yingzhexu/esp32-codex-quota-gauge/hardware/images/V5_servo_posts.png

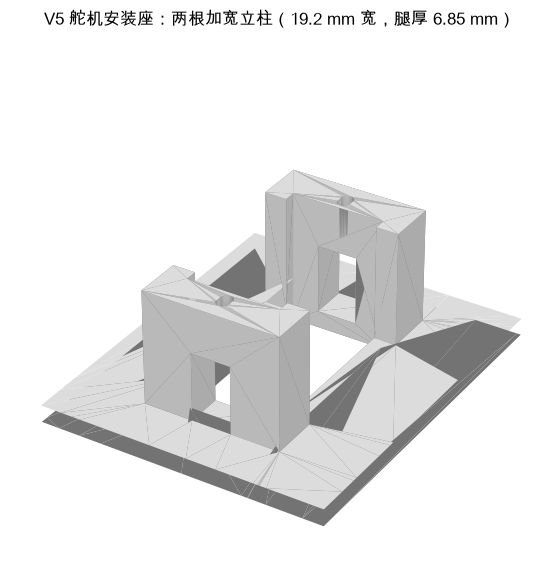
hardware/images/V5_servo_posts.png
