yingzhexu/esp32-codex-quota-gauge/hardware/CAD/V5_full_assembly.step

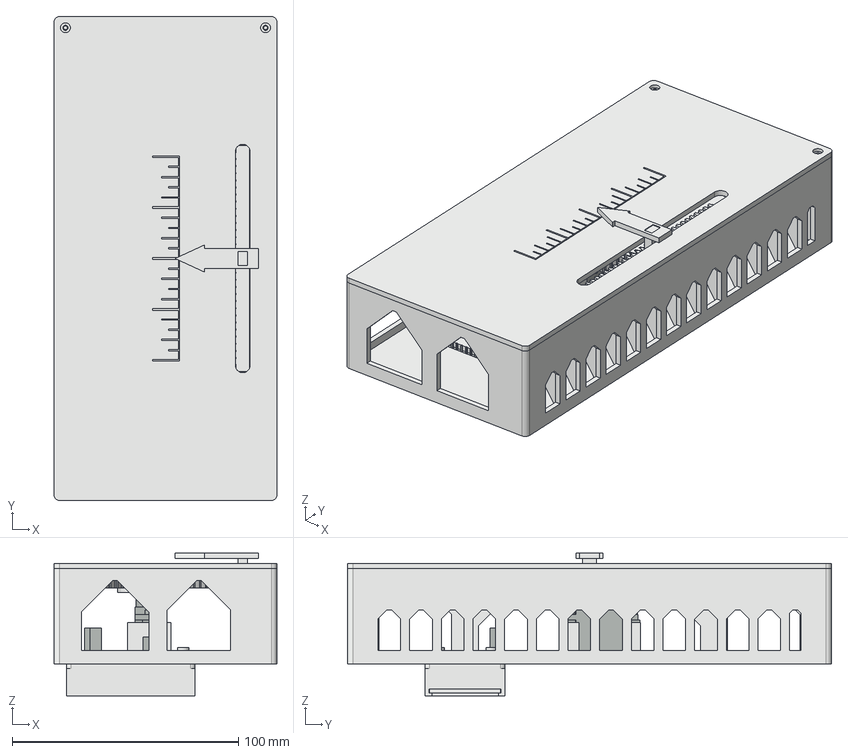
[picture p3: CAD file, 2026-10-23]
hardware/CAD/V5_full_assembly.step
98.5 x 214.0 x 63.2 mm
01_plaque_back
02_front
03_pinion_74T
04_horn_keeper
05_rack_slider
06_arrow
07_pod_base
08_pod_lid
REF_SG90
REF_EAR_SHIMS
REF_HORN
REF_HORN_SCREW
REF_PCB
REF_COMPONENTS
REF_USB
REF_HEADERS
REF_DUPONT_ENVELOPE
