yingzhexu/esp32-codex-quota-gauge/hardware/CAD/T5_horn_fit.step

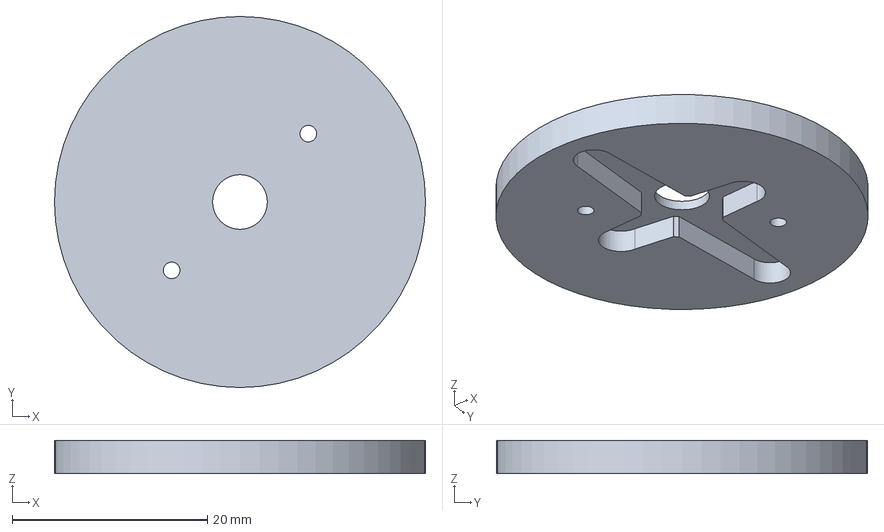
[picture p4: CAD file, 2026-10-23]
hardware/CAD/T5_horn_fit.step
38.0 x 38.0 x 3.40 mm
