yingzhexu/esp32-codex-quota-gauge/hardware/STL/S_servo_ear_shim_1.0mm_print2.stl

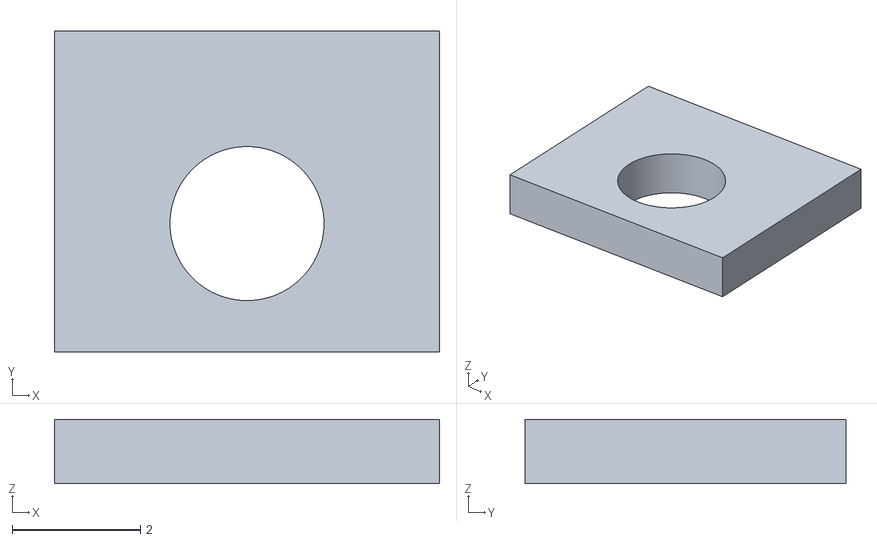
[picture p5: CAD file, 2026-10-23]
hardware/STL/S_servo_ear_shim_1.0mm_print2.stl
6.00 x 5.00 x 1.00
