yingzhexu/esp32-codex-quota-gauge/hardware/CAD/T3_pilot_and_journal.step

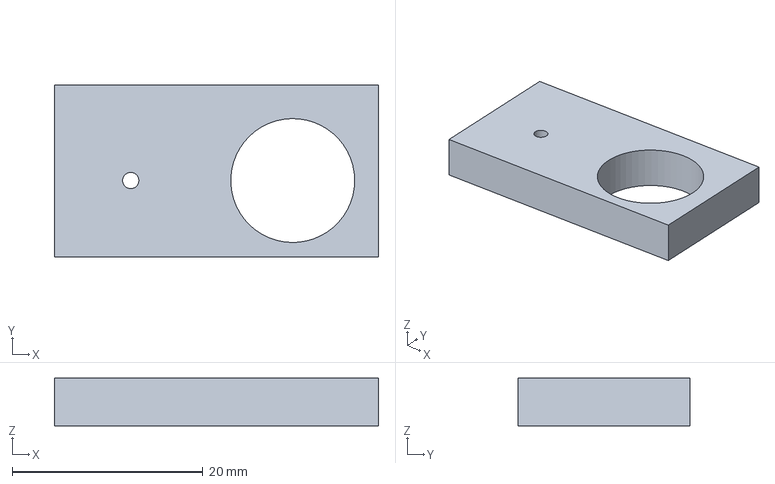
[picture p6: CAD file, 2026-10-23]
hardware/CAD/T3_pilot_and_journal.step
34.0 x 18.0 x 5.00 mm
