yingzhexu/esp32-codex-quota-gauge/hardware/CAD/T2_slider_sample.step

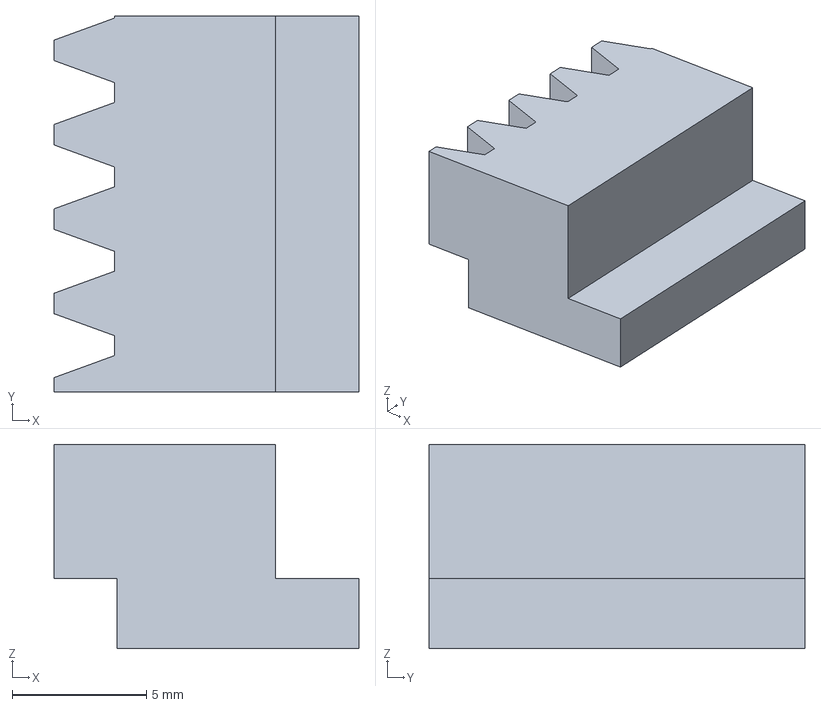
[picture p8: CAD file, 2026-10-23]
hardware/CAD/T2_slider_sample.step
11.3 x 14.0 x 7.60 mm
