yingzhexu/esp32-codex-quota-gauge/hardware/CAD/02_front.step

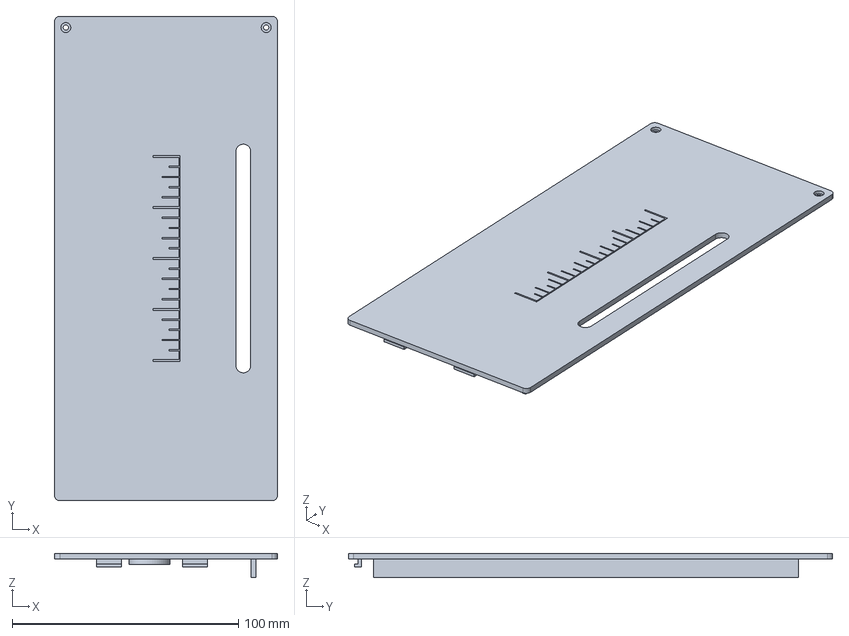
[picture p10: CAD file, 2026-10-23]
hardware/CAD/02_front.step
98.5 x 214.0 x 10.7 mm
