yingzhexu/esp32-codex-quota-gauge/hardware/STL/S_servo_ear_shim_0.5mm_print2.stl

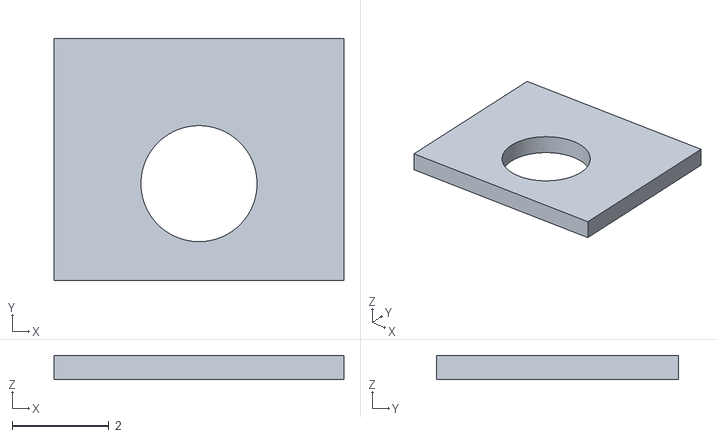
[picture p11: CAD file, 2026-10-23]
hardware/STL/S_servo_ear_shim_0.5mm_print2.stl
6.00 x 5.00 x 0.5
