yingzhexu/esp32-codex-quota-gauge/hardware/CAD/07_pod_base.step

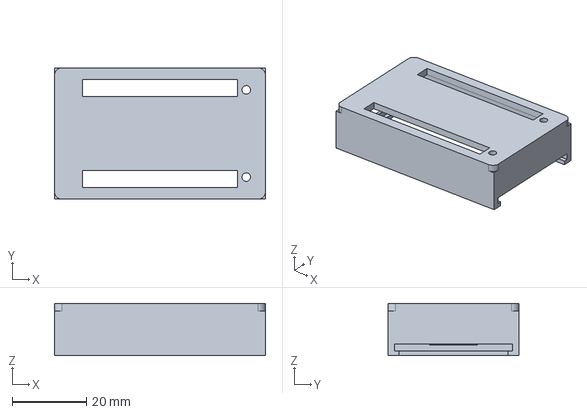
[picture p12: CAD file, 2026-10-23]
hardware/CAD/07_pod_base.step
56.9 x 35.3 x 14.1 mm
