yingzhexu/esp32-codex-quota-gauge/hardware/STL/optional_horn_spacer_0.8mm.stl

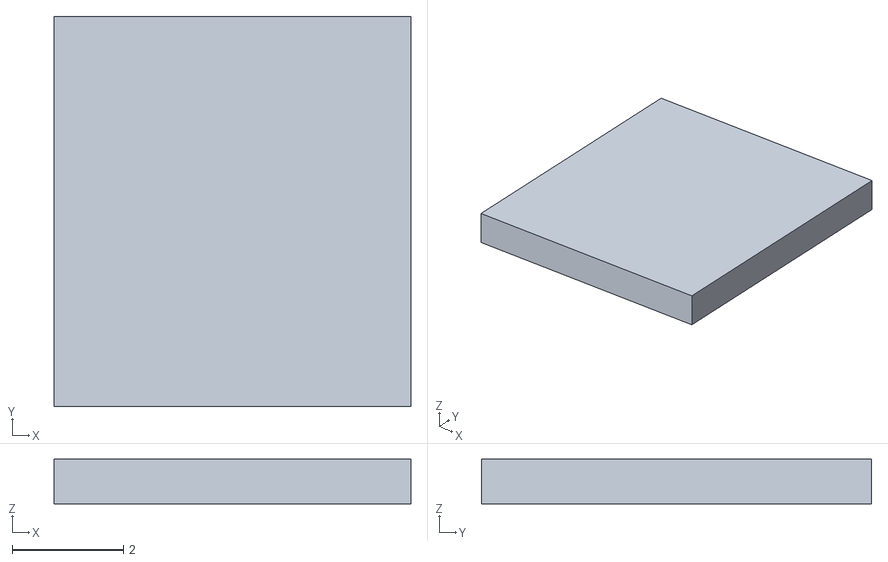
[picture p13: CAD file, 2026-10-23]
hardware/STL/optional_horn_spacer_0.8mm.stl
6.40 x 7.00 x 0.8
