yingzhexu/esp32-codex-quota-gauge/hardware/CAD/T4_front_lip_sample.step

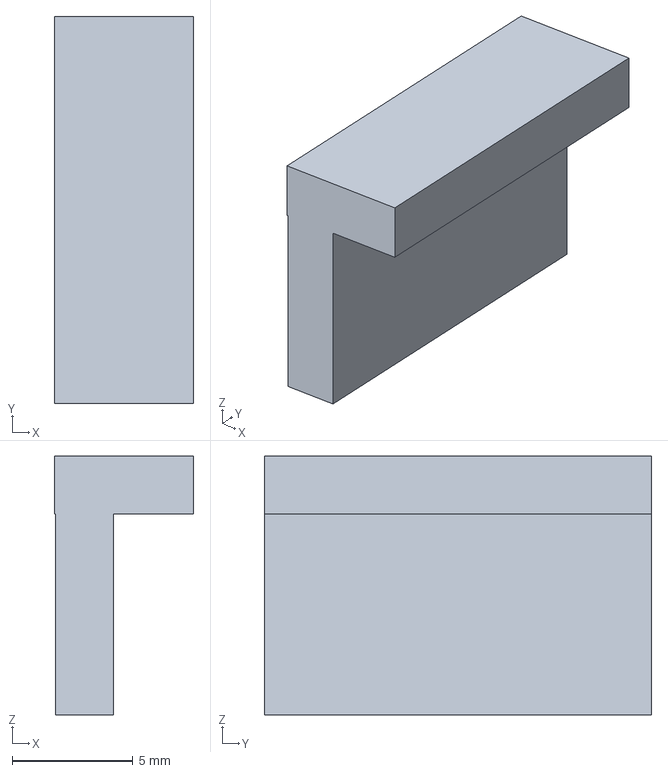
[picture p14: CAD file, 2026-10-23]
hardware/CAD/T4_front_lip_sample.step
5.75 x 16.0 x 10.7 mm
