yingzhexu/esp32-codex-quota-gauge/hardware/STL/S_servo_ear_shim_2.0mm_print2.stl

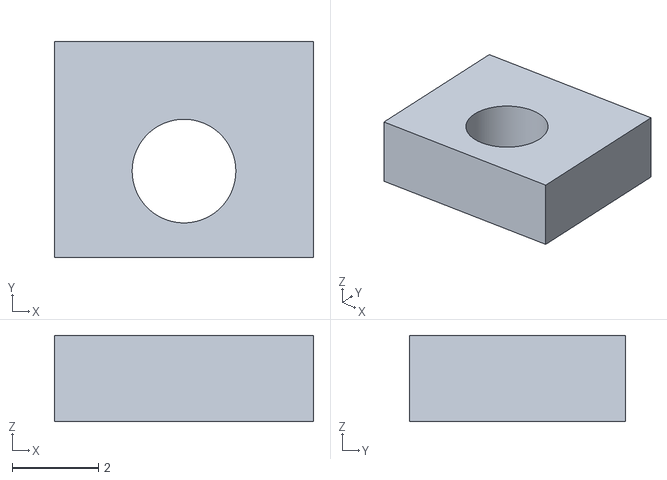
[picture p15: CAD file, 2026-10-23]
hardware/STL/S_servo_ear_shim_2.0mm_print2.stl
6.00 x 5.00 x 2.00
