yingzhexu/esp32-codex-quota-gauge/hardware/CAD/05_rack_slider.step

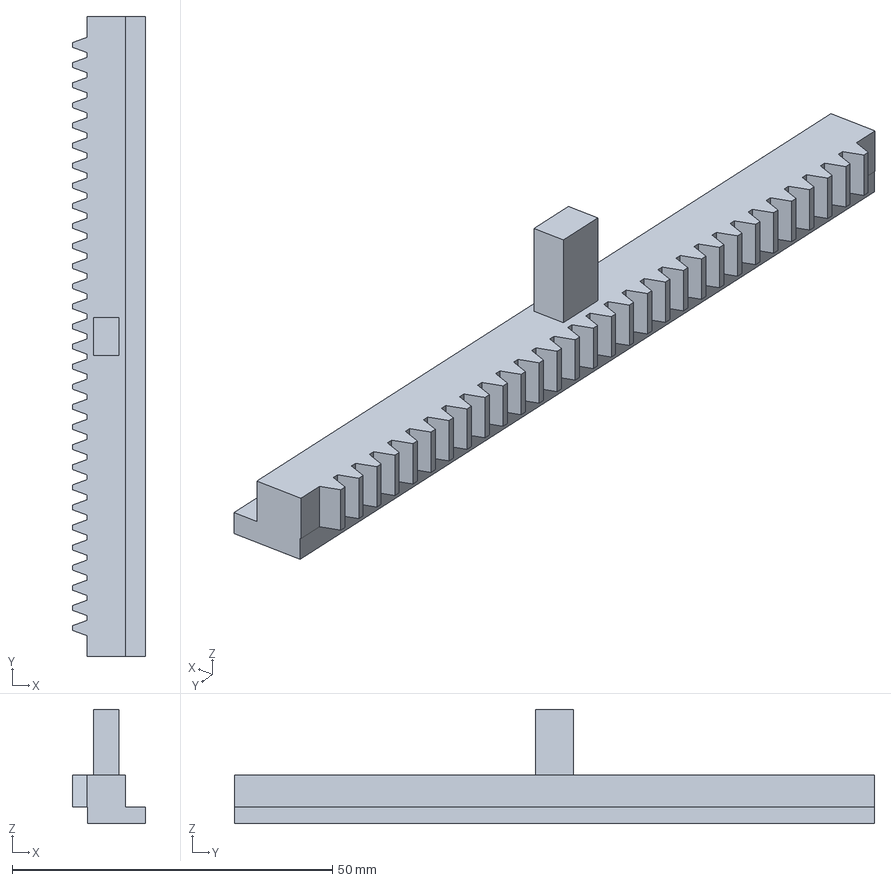
[picture p16: CAD file, 2026-10-23]
hardware/CAD/05_rack_slider.step
11.3 x 100.0 x 17.9 mm
