yingzhexu/esp32-codex-quota-gauge/hardware/CAD/T1_guide_sample.step

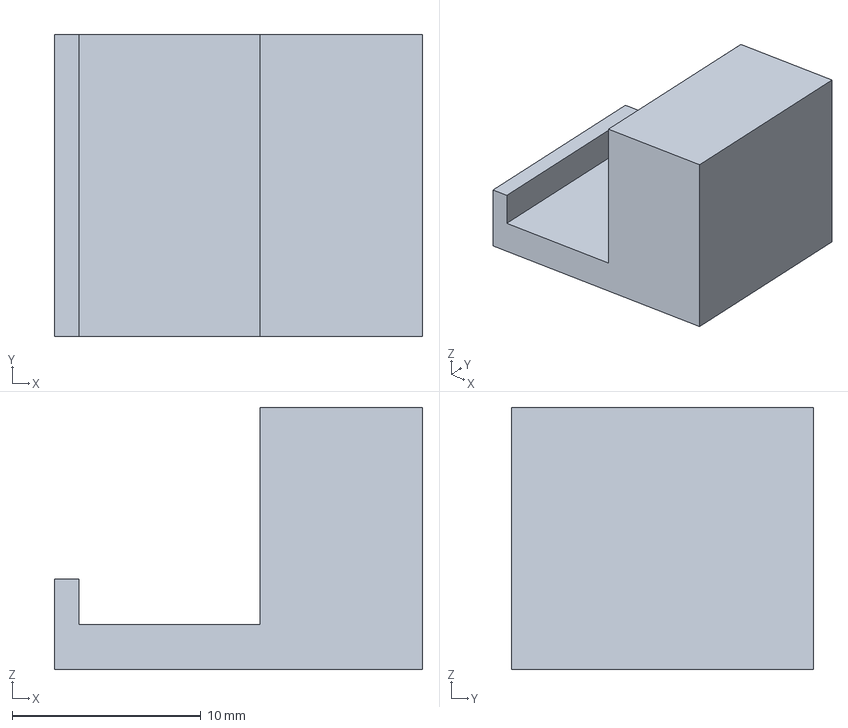
[picture p17: CAD file, 2026-10-23]
hardware/CAD/T1_guide_sample.step
19.5 x 16.0 x 13.9 mm
