yingzhexu/esp32-codex-quota-gauge/hardware/CAD/06_arrow.step

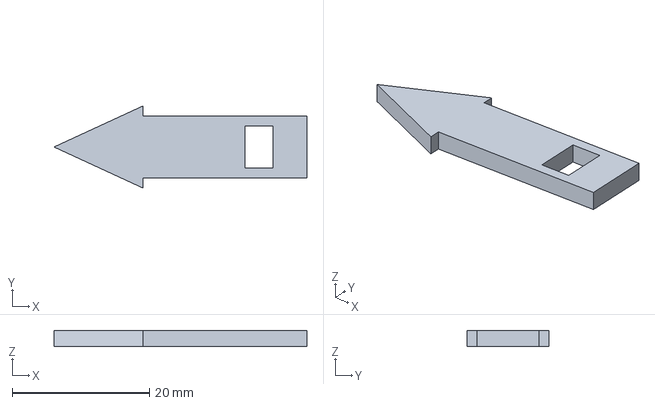
[picture p18: CAD file, 2026-10-23]
hardware/CAD/06_arrow.step
36.9 x 12.0 x 2.40 mm
