yingzhexu/esp32-codex-quota-gauge/hardware/CAD/03_pinion_74T.step

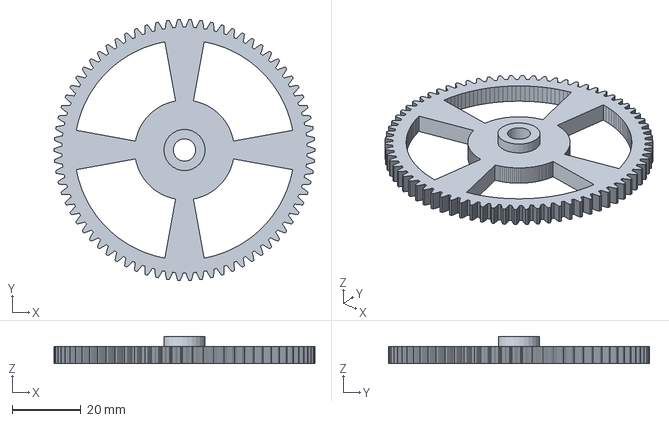
[picture p19: CAD file, 2026-10-23]
hardware/CAD/03_pinion_74T.step
76.0 x 76.0 x 7.90 mm
