yingzhexu/esp32-codex-quota-gauge/hardware/CAD/08_pod_lid.step

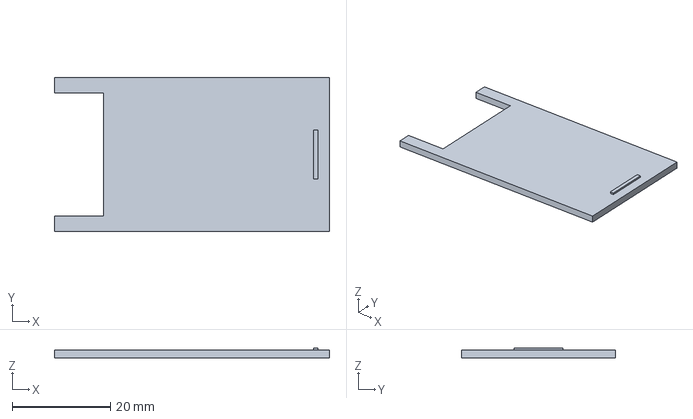
[picture p20: CAD file, 2026-10-23]
hardware/CAD/08_pod_lid.step
55.9 x 31.3 x 2.00 mm
