yingzhexu/esp32-codex-quota-gauge/hardware/CAD/04_horn_keeper.step

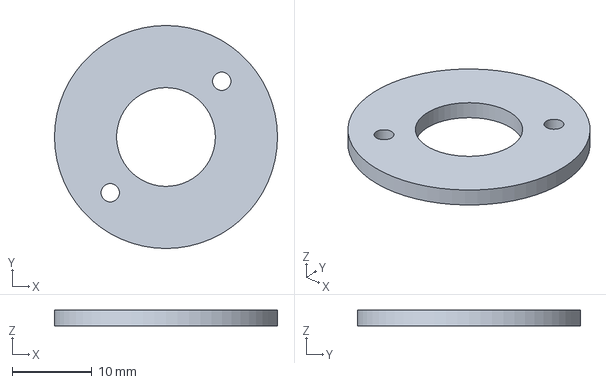
[picture p21: CAD file, 2026-10-23]
hardware/CAD/04_horn_keeper.step
28.0 x 28.0 x 2.00 mm
