yingzhexu/esp32-codex-quota-gauge/hardware/CAD/01_plaque_back.step

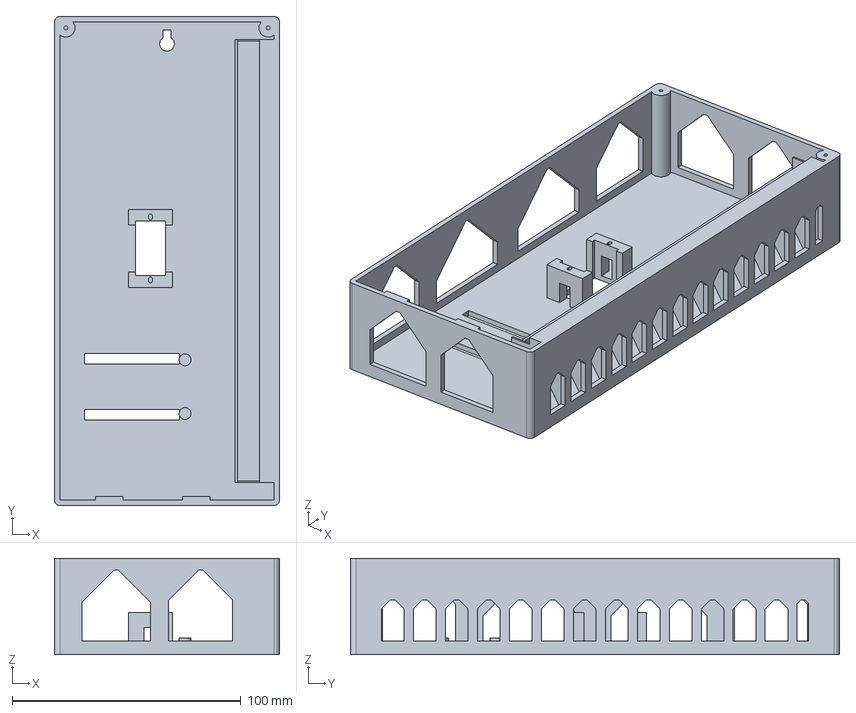
[picture p22: CAD file, 2026-10-23]
hardware/CAD/01_plaque_back.step
98.5 x 214.0 x 42.2 mm
