yingzhexu/esp32-codex-quota-gauge/(list of files, cad)

Other CAD files:
hardware/STL/01_plaque_back.stl
hardware/STL/02_front.stl
hardware/STL/03_pinion_74T.stl
hardware/STL/04_horn_keeper.stl
hardware/STL/05_rack_slider.stl
hardware/STL/06_arrow.stl
hardware/STL/07_pod_base.stl
hardware/STL/08_pod_lid.stl
hardware/STL/T1_guide_sample.stl
hardware/STL/T2_slider_sample.stl
hardware/STL/T3_pilot_and_journal.stl
hardware/STL/T4_front_lip_sample.stl
hardware/STL/T5_horn_fit.stl
