yingzhexu/esp32-codex-quota-gauge/(commit log)

2026-10-23 feat: add organized hardware, ESP32 firmware, macOS app and downloads
    Include 3D-printable STL parts, STEP models and CAD sources, verification reports,
    BLE firmware, macOS sources and installer, Python tools, and bilingual documentation.
    Add direct download links and Git file handling rules.
    [01_plaque_back.step, 01_plaque_back.stl, 02_front.step, 02_front.stl, 03_pinion_74T.step, 03_pinion_74T.stl, 04_horn_keeper.step, 04_horn_keeper.stl]
2026-10-24 feat: rename to Mechanical Gauge (机械指针) and add game gauge mode
    - macOS app renamed to 机械指针 (MechanicalGauge.dmg, macOS 14+); Codex quota and
    game gauge modes switchable in Settings
    - Game gauge: ScreenCaptureKit + Vision OCR reads on-screen instruments
    - racing: speedometer, simulated tachometer, manual tachometer (rpm bar + lit gear)
    - flight: speedometer and altimeter (drum counters)
    - glyph-count check with accurate re-read, flight smoothing, redline flash hold
    - region picker works over full-screen games
    - Firmware moved to firmware/MechanicalGaugeBLE (V5): SPEED up to 1000 deg/s; BLE name
    and saved calibration unchanged
    - Python tool renamed to tools/python/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
